olevasseur/thermostat-dial-controller/stl/wheel_drive_mount_v0_2_frame_plate_wheel.stl

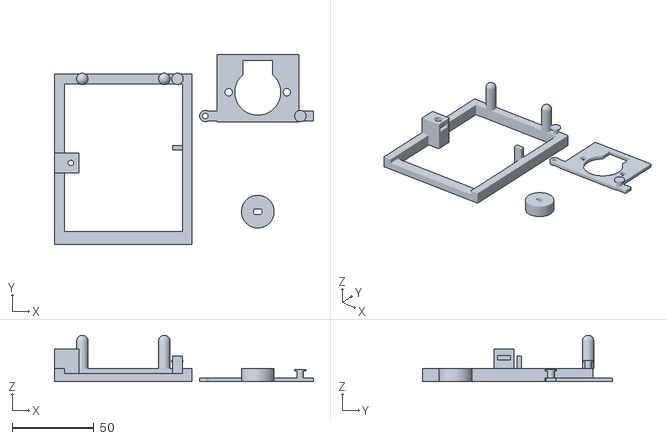
[picture p6: CAD file, 2026-10-12]
stl/wheel_drive_mount_v0_2_frame_plate_wheel.stl
158.0 x 115.8 x 28.3
