olevasseur/thermostat-dial-controller/stl/front_clip_v0_5_x2.stl

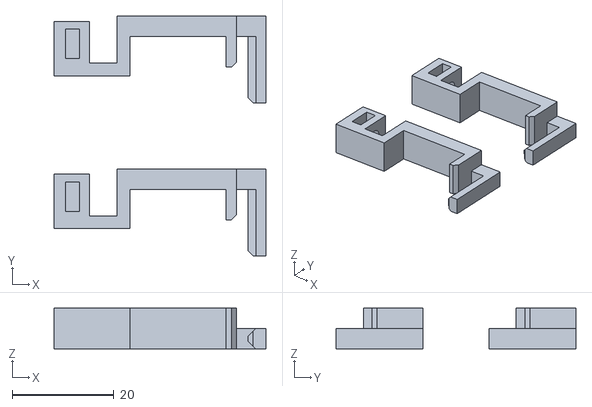
[picture p7: CAD file, 2026-10-12]
stl/front_clip_v0_5_x2.stl
41.6 x 47.0 x 8.00
