olevasseur/thermostat-dial-controller/stl/bottom_slider_clip_v0_1.stl

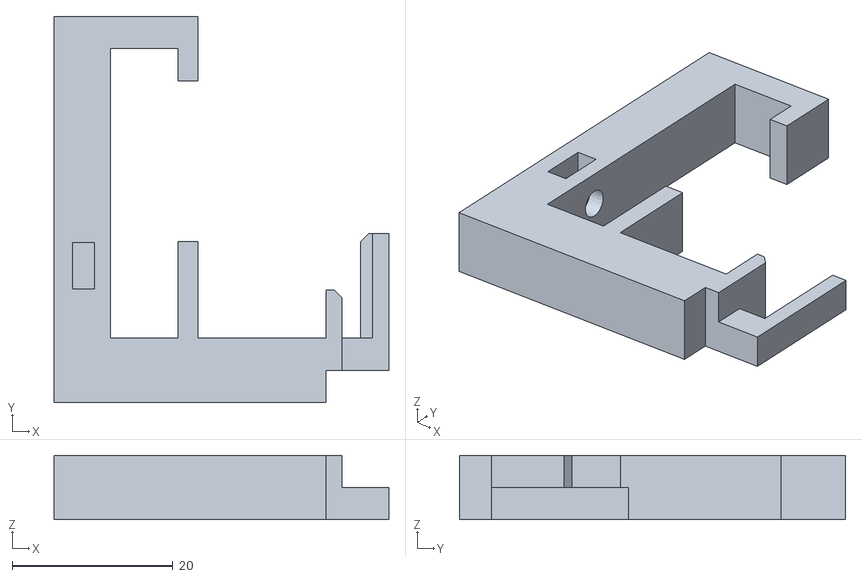
[picture p8: CAD file, 2026-10-12]
stl/bottom_slider_clip_v0_1.stl
41.6 x 48.0 x 8.00
