olevasseur/thermostat-dial-controller/(commit log)

2026-10-12 Initial commit: thermostat dial controller
    ESP32 firmware with a built-in phone page, OpenSCAD sources and STLs for
    the clip-on friction-wheel mount, wiring notes, and a demo video.
    [bottom_slider_clip_v0_1.stl, front_clip_v0_5_x2.stl, thermostat_bottom_slider_clip_v0_1.scad, thermostat_front_clip_v0_5.scad, thermostat_wheel_drive_mount_v0_2.scad, wheel_drive_mount_v0_2_frame_plate_wheel.stl]
2026-10-12 Use a frame from the demo video as the installed photo
2026-10-13 Add CAD renders of the mount from several angles
    [preview.scad]
